yzhajlydy/Micro-Quadrotor/(commit log)

2015-04-18 A mirco-quadrotor project
    Folder "HAL": Hardware LeveL. Some basic hardware dirivers for
    STM32F1xx, IMU, NRF24L01 etc.;
    Folder "Startup": Startup code for STM32F1xx;
    Folder "STM32LIB": ST microcontroller standard peripheral libaray;
    Folder "User": IMU Fusion algorithm and PID control.
2015-04-18 DMA driver
2015-04-19 Hardware Drivers
    DMA驱动函数
2015-04-19 Revert "Hardware Drivers"
    This reverts commit 6fe4ad26f64d72a0cd9412f421f2488c757b3937.
    [DMA.c, DMA.h]
2015-04-19 Revert "Revert "Hardware Drivers""
    This reverts commit a0f732c9ef49fe4c491a423eeae49005ba72a495.
    [DMA.c, DMA.h]
2015-04-19 Revert "Revert "Revert "Hardware Drivers"""
    This reverts commit d591b3f583aece77266a50305f66cb1b418b04d9.
    [DMA.c, DMA.h]
2015-04-19 Hardware Level Drivers
    STM32F1xx硬件层驱动函数
2015-04-19 Project description
    项目描述
    2013年10月设计的一款微型四旋翼飞行器,具体介绍参见http://blog.csdn.net/nemol1990/article/details/18698927
2015-04-19 Quadrotor schematic
    四旋翼飞行器原理图
2015-04-19 Main apps
    主函数及其相关函数
    控制函数Control.c
    姿态解算函数Fusion.c
2015-04-19 Keil v4 project
    KEIL4工程文件
2015-04-19 Hardware Level Drivers
    硬件驱动函数
2015-04-19 Startup
    STM32F1xx启动函数
2015-04-19 STM32F1 standard peripheral library
    STM32F1标准外围库
2015-04-19 Main Apps
    用户主函数
